chrisb2/battery-monitor/complete-project.jpg

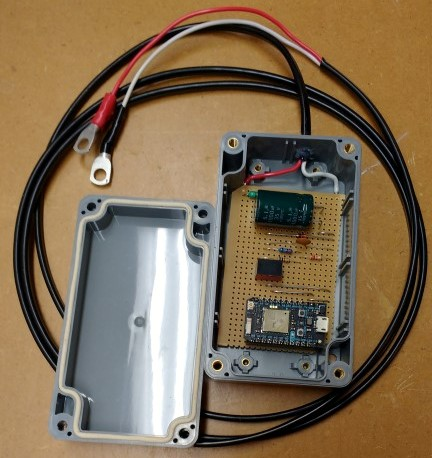
complete-project.jpg
