chrisb2/battery-monitor/(commit log)

2016-08-26 Add battery low event and format value of volts
2016-08-27 Add circuit diagram
2016-08-27 Update circuit diagram
2016-08-27 Update read me with circuit diagram and add to .gitignore
2016-09-20 Add ADC averaging to mitigate noise in the battery voltage measurement
    [battery-monitor.ino]
2016-09-20 Add fuse to circuit to protect against high currents should a short occur
2016-09-24 Implement 'Averaging of N-X ADC samples'
2016-09-24 Correction to 'Averaging of N-X ADC samples'
    [battery-monitor.ino]
2016-10-07 Measure voltage before connecting to avoid ADC noise due to network activity
    [battery-monitor.ino]
